NarinLab/Udawa/README.md

# Udawa 
Universal Digital Agriculture Watering Assistant or known by the brand name UDAWA, is an open-source precision farming platform designed and developed to be used by small-scale farmers especially in hydroponic based growing system. UDAWA was developed by the Information Technology Study Program, Faculty of Engineering and Informatics, Universitas Pendidikan Nasional. The UDAWA platform consists of a build and use manual, hardware design, software source code and serverless computing architecture design. So, the UDAWA platform can be used and developed by anyone freely. In terms of functionality, the UDAWA platform provides benefits in terms of automation and computerization of farming processes, thereby increasing the productivity and efficiency of smallholder farming processes who has a lack in funding or access to the latest technology in agriculture.
