NarinLab/Udawa/(threads)

Thread 3 (2021-09-09):

UDAWA Actuator4CH - Tambah Screw Terminal Block

iwas108, 2021-09-09:
Pada issue ini main tasknya adalah menambahkan koneksi ke modul relay 4 Channel.
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

Relay 4 Channel punya 4 pin input (INx atau pada gambar diagram Cx). 4 Pin input ini dipetakan ke pin ESP32 yang telah dicek terlebih dahulu untuk memastikan pin tersebut tidak menimbulkan masalah jika digunakan (search: ESP32 usable pin). Masing-masing dimulai dari **C1 hingga C4: D32, D33, D25, D26**. Pin GND dan pin 5V disambungkan ke pin yang sama.

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

Untuk bagian tegangan tinggi (listrik PLN) yang akan mentenagai beban, sebelum masuk ke terminal block **~RCx** yang akan mengarah ke modul relay, ditambahkan fuse holder (rumah skring) kaca silinder sebagai pengaman. Kemudian, kabel ini akan masuk ke bagian **Common** dari masing-masing relay. Kabel yang satunya lagi keluar dari terminal NO (**Normally Open**) menuju ke PCB dan masuk di terminal **~NOx**. Dari terminal **~NOx**, daya listrik tegangan tinggi akan disambungkan oleh jalur tegangan tinggi PCB ke terminal akhir tempat dimana stop kontak akan disambungkan (**CHx**).

### To Do
1. Tambahkan pada skematik untuk terminal 220V (2 block x 1)
2. Tambahkan pada skematik untuk terminal AC/DC (2 block x 1)
3. Tambahkan pada skematik untuk terminal control relay (Cx + VCC + GND) (2 block x 3)
4. Tambahkan pada skematik untuk fuse holder (4 unit)
5. Tambahkan pada skematik untuk terminal block ~RCx (2 block x 2)
6. Tambahkan pada skematik untuk terminal block ~NOx (2 block x 2)
7. Tambahkan pada skematik untuk terminal block stop kontak CHx (2 block x 4)
8. Lakukan wiring pada mode board dan pastikan penamaan setiap pin dan konektor dibuat dengan jelas dan rapi sesuai diagram.

### Pembagian tugas
Pembagian tugas saya serahkan ke masing-masing tim leader, untuk penamaan branch pekerjaan saya bebaskan asal mengikuti aturan common sense sehingga jelas dan mudah untuk dimengerti. Untuk detail diskusi seperti nama part silahkan diskusi di issue ini agar terdokumentasi dengan baik untuk di masa depan, dan orang umum juga bisa melihat.

Tim leader juga bisa membuat issue tambahan sendiri untuk meassign rekannya tugas terkait. Ingat untuk menambahkan project di sidebar kanan halaman, gunakan projek sesuai issue yang sedang dikerjakan. Misalnya issue ini terkait dengan hardware pada varian Actuator4CH, maka project yang dikaitkan adalah HW-Actuator-4CH. Untuk label bisa gunakan **enhancement** untuk pengerjaan fitur baru.

iwas108, 2021-09-09:
Untuk fuse holder, tolong dibantu untuk mencarikan part number yang cocok di eagle. Kita gunakan model Fuse Holder PCB Mount 5x20 seperti ini:
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

artawiguna, 2021-09-09:
selamat malam pak, ijin bertanya untuk relaynya 2 block x3 itu jadinya 6 ya pak... kalau sesuai di diagram ada 4 pak, jadinya pakai yang mana pak?

iwas108, 2021-09-09:
> selamat malam pak, ijin bertanya untuk relaynya 2 block x3 itu jadinya 6 ya pak... kalau sesuai di diagram ada 4 pak, jadinya pakai yang mana pak?

Maksudnya jika ada 6 pin yang akan dipasangkan terminal block, maka kita gunakan terminal block 2 pin sebanyak 3 buah. Atau biar tidak ruwet, semua pin kita gunakan terminal block 2 pin (**W237-102**).

Untuk fuse holder sudah ketemu: http://www.diymodules.org/eagle-show-object?type=std&file=fuse.lbr&package=FUSE_HOLDER_5X20MM

Tolong dibantu untuk download dan tambah library tersebut ke folder library.

artawiguna, 2021-09-09:
kemudian  terminal 220V di tambahkan dimananya pak?
soalnya kalo ga salah di eagle sudah di tambahkan pak

iwas108, 2021-09-09:
> kemudian terminal 220V di tambahkan dimananya pak?
> soalnya kalo ga salah di eagle sudah di tambahkan pak

Terminal yg sudah ada tidak perlu ditambahkan lagi, itu hanya untuk melengkapi diagram saja

artawiguna, 2021-09-09:
> semua

oww jadi pin nya ada 6 yaa pak... maaf saya kira tadi relaynya 6 ch

iwas108, 2021-09-09:
> > semua
>
> oww jadi pin nya ada 6 yaa pak... maaf saya kira tadi relaynya 6 ch

Yes, Pin relay 4 channel punya 6 pin,4 untuk kontrol (C1, C2, C3, C4), dan dua untuk power (5V dan GND).

artawiguna, 2021-09-09:
malam pak ijin bertanya kembali untuk penamaan setiap pin tidak bisa sesuai dengan diagram karena pin yang kedua menyesuaikan valuenya dengan pin yang pertama, mohon arahannya
terimakasih
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

iwas108, 2021-09-10:
> malam pak ijin bertanya kembali untuk penamaan setiap pin tidak bisa sesuai dengan diagram karena pin yang kedua menyesuaikan valuenya dengan pin yang pertama, mohon arahannya
> terimakasih
> 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

Coba di samain saja namamya, NO12, NO34.. untuk nama wire/label pastikan sama agar terhubung

artawiguna, 2021-09-10:
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

baik siap pak

artawiguna, 2021-09-13:
Selamat pagi pak ijin bertanya untuk GND dan 5V yang dari HLK boleh di pindah pak?
soalnya Relaynya jauh jadinya ngambil GND dan 5V... maksunya itu di switch

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

iwas108, 2021-09-13:
Slamat pagi, dipindah saja yg penting efisien dan pikirkan nanti kemudahannya untuk mengakses komponen

artawiguna, 2021-09-14:
> Slamat pagi, dipindah saja yg penting efisien dan pikirkan nanti kemudahannya untuk mengakses komponen
baik siap pak

Closed 2021-11-12.

Thread 5 (2021-09-09):

UDAWA Sensor Water - Tambahkan Library Berikut ke Folder Hardware/Lib

iwas108, 2021-09-09:
Perlu bantuan untuk mencari dan menambahkan library pendukung untuk projek Sensor Water (Water sensor dengan TDS dan Temperature):

1.  Arduino Nano
2. Bi-Directional Logic Level Converter

iwas108, 2021-09-09:
Tim leader bisa assign rekannya yang lain untuk membantu, ada dua orang yang belum approve invitation untuk jadi kolaborator

Closed 2021-09-13.

Thread 6 (2021-09-09):

UDAWA Sensor Water - Tambah Komponen Utama

iwas108, 2021-09-09:
Pekerjaan besar untuk tim yang mengerjakan HW Sensor varian water sensor (TDS dan Water Temperature). Untuk diagram pengkabelan dibuat seperti berikut:

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

### To do
1. Tambahkan komponen Arduino Nano
2. Tambahkan komponen Logic Level Converter
3. Tambahkan Terminal Block untuk koneksi ke Sensor TDS dan Sensor DS18B20
3. Lakukan Wiring sesuai diagram
4. Lakukan Routing pada mode board

### Pengerjaan
Tim leader bisa bagi tugas kepada rekannya yang lain, nama branch saya bebaskan asal sesuai common sense dan mudah dimengerti. Semua diskusi terkait issue silahkan diskusikan disini sebagai dokumentasi.

WidiaPrasetia, 2021-09-11:
Selamat malam pak,
Saya stuck di To Do no 3
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
Mohon petunjuknya untuk gambar yang saya kirimkan ini pak. Terima kasih

iwas108, 2021-09-13:
Pakai part resistor pras,rubah nilainya (value) sesuai gambar. Pakai jenis resistor through hole

WidiaPrasetia, 2021-09-13:
untuk penambahan terminal block untuk koneksi ke sensor ditambahkan di sebelah mana ya pak? karena digambar saya lihat semua langsung nyambung. maaf kalau ada keliru pak

iwas108, 2021-09-13:
> untuk penambahan terminal block untuk koneksi ke sensor ditambahkan di sebelah mana ya pak? karena digambar saya lihat semua langsung nyambung. maaf kalau ada keliru pak

Di bagian sensornya. Anggap sensor itu terminal block.

pande34, 2021-09-17:
ijin bertanya Pak Adit untuk kabelnya ngga boleh ditumpuk pak?

pande34, 2021-09-17:
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

iwas108, 2021-09-18:
routing nya tidak boleh di tumpuk, itu tantangannya saat merouting dan mengatur tata letak, bagaimana caranya agar jalur data / power tidak saling bertabrakan atau bersentuhan.

Solusi akhir juga terlalu rumit, bisa gunakan vias pada sisi bottom. Bisa cari di youtube cara menggunakan vias di eagle untuk menambahkan jalur biru (bawah).

Closed 2021-11-12.

Thread 7 (2021-09-09):

Firmware - Init PlatformIO Untuk Actuator4CH-ESP32

NarinLab, 2021-09-09:
Buat folder Firmware di folder root repository, dan inisialisasi projek dengan PlatformIO (Pio). Detail projek yang diinisialisasi adalah:

1. Nama Projek: Actuator4CH-ESP32
2. Jenis Framework: Arduino
3. Jenis Board: esp32doit-devkit-v1
4. Tambahkan library: NTPClient, ArduinoJson, StreamUtils, LittleFS_esp32, TaskManagerIO

Sehingga folder Pio untuk Actuator4CH-ESP32 menjadi: **Firmware/Actuator4CH-ESP32**

Closed 2021-09-09.

Thread 8 (2021-09-09):

Firmware - Init PlatformIO Untuk SensorWater-ESP32

iwas108, 2021-09-09:
Inisialisasi projek untuk firmware SensorWater-ESP32 dengan PlatformIO (Pio). Detail projek yang diinisialisasi adalah:

1. Nama Projek: SensorWater-ESP32
2. Jenis Framework: Arduino
3. Jenis Board: esp32doit-devkit-v1
4. Tambahkan library: NTPClient, ArduinoJson, StreamUtils, LittleFS_esp32, TaskManagerIO

Sehingga folder Pio untuk Actuator4CH-ESP32 menjadi: Firmware/SensorWater-ESP32

Closed 2021-09-13.

Thread 9 (2021-09-09):

Firmware - Init PlatformIO Untuk SensorWater-Nano

iwas108, 2021-09-09:
Lakukan inisialisasi firmware untuk projek SensorWater-Nano dengan PlatformIO (Pio). Detail projek yang diinisialisasi adalah:

1. Nama Projek: SensorWater-Nano
2. Jenis Framework: Arduino
3. Jenis Board: nanoatmega328new
4. Tambahkan library: ArduinoJson, StreamUtils, TaskManagerIO, OneWire, DallasTemperature

Sehingga folder Pio untuk Actuator4CH-ESP32 menjadi: Firmware/SensorWater-Nano

WidiaPrasetia, 2021-09-10:
Selamat siang pak, saya mau bertanya pak.
Untuk kalimat ini "Sehingga folder Pio untuk Actuator4CH-ESP32 menjadi: Firmware/SensorWater-Nano" bagaimana maksudnya ya pak? Apakah ganti nama foldernya atau bagaimana pak?
Mohon arahannya pak, maaf saya sedikit bingung

iwas108, 2021-09-10:
> Selamat siang pak, saya mau bertanya pak. @iwas108
> Untuk kalimat ini "Sehingga folder Pio untuk Actuator4CH-ESP32 menjadi: Firmware/SensorWater-Nano" bagaimana maksudnya ya pak? Apakah ganti nama foldernya/buat project baru di PIO atau bagaimana pak?
> Mohon arahannya pak, maaf saya sedikit bingung

Pas buat projek, buat nama projeknya sesuai nama folder, dan lokasi projek taruh di dalam folder Firmware. Contohnya sama seperti yg saya init untuk firmware bagian Actuator4CH

Closed 2021-09-13.

Thread 17 (2021-10-15):

Test Code untuk Sensor TDS

iwas108, 2021-10-15:
Berikut penggalan test code untuk sensor TDS di board nano:

```
void MadavaCoMCU::getWaterEC(StaticJsonDocument<DOCSIZE> &doc)
{
  pinMode(configCoMCU.pinEcPower, OUTPUT);
  pinMode(configCoMCU.pinEcGnd, OUTPUT);
  pinMode(configCoMCU.pinEcData, INPUT);

  float ec = 0;
  float ec25 = 0;
  int ppm = 0;
  float raw = 0;
  float voltageDrop = 0;
  float rc = 0;
  float waterTemp = doc["params"]["waterTemp"].as<float>();

  digitalWrite(configCoMCU.pinEcPower, HIGH);
  raw = analogRead(configCoMCU.pinEcData);
  raw = analogRead(configCoMCU.pinEcData);
  digitalWrite(configCoMCU.pinEcPower, LOW);

  voltageDrop = (configCoMCU.pEcVin * raw) / 1024.0;
  rc =(voltageDrop * configCoMCU.pEcR1) / (configCoMCU.pEcVin - voltageDrop);
  rc = rc - configCoMCU.pEcRa;
  ec = 1000 / (rc * configCoMCU.pEcKcoe);

  ec25  =  ec / (1 + configCoMCU.pEcTcoe * (waterTemp - 25.0));
  ppm =(ec25) * (configCoMCU.pEcPpm * 1000);

  JsonObject params = doc.createNestedObject("params");
  doc["method"] = "setWaterEC";
  params["waterEC"] = ec25;
  params["waterPPM"] = ppm;
  params["waterTemp"] = waterTemp;
  params["vDrop"] = voltageDrop;
  params["_ec"] = ec;
  params["raw"] = raw;
  serialWriteToESP32(doc);
}

```

iwas108, 2021-11-06:
Contoh Syncron:

```
{
  "fPanic": false,
  "pEcKcoe": 2.9,
  "pEcTcoe": 0.019,
  "pEcVin": 4.54,
  "pEcPpm": 0.5,
  "pEcR1": 0.5,
  "pEcRa": 25,
  "bfreq": 1600,
  "fBuzz": true,
  "pRlyOn": false,
  "pRlyOff": true,
  "pinBuzzer": 3,
  "pinLedR": 9,
  "pinLedG": 10,
  "pinLedB": 11,
  "pinEcPower": 15,
  "pinEcGnd": 16,
  "pinEcData": 14,
  "method": "setConfigCoMCU"
}
```

artawiguna, 2021-11-06:
/*
  ElCheapo Arduino EC-PPM measurments

  This scrip uses a common USA two prong plug and a 47Kohm Resistor to measure the EC/PPM of a Aquaponics/Hydroponics Sytem.
  You could modift this code to Measure other liquids if you change the resitor and values at the top of the code.

  This Program will give you a temperature based feed controller. See Read me in download file for more info.

  28/8/2015  Michael Ratcliffe  Mike@MichaelRatcliffe.com

          This program is free software: you can redistribute it and/or modify
    it under the terms of the GNU General Public License as published by
    the Free Software Foundation, either version 3 of the License, or
    (at your option) any later version.

    This program is distributed in the hope that it will be useful,
    but WITHOUT ANY WARRANTY; without even the implied warranty of
    MERCHANTABILITY or FITNESS FOR A PARTICULAR PURPOSE.  See the
    GNU General Public License for more details.

    You should have received a copy of the GNU General Public License
    along with this program.  If not, see .

    Parts:
    -Arduino - Uno/Mega
    -Standard American two prong plug
    -1 kohm resistor
    -DS18B20 Waterproof Temperature Sensor

    Limitations:
    -
    -

    See www.MichaelRatcliffe.com/Projects for a Pinout and user guide or consult the Zip you got this code from

*/

//************************** Libraries Needed To Compile The Script [See Read me In Download] ***************//
// Both below Library are custom ones [ SEE READ ME In Downloaded Zip If You Dont Know how To install] Use them or add a pull up resistor to the temp probe

#include <OneWire.h>
#include <DallasTemperature.h>

//************************* User Defined Variables ********************************************************//

//##################################################################################
//-----------  Do not Replace R1 with a resistor lower than 300 ohms    ------------
//##################################################################################

int R1= 1000;
int Ra=25; //Resistance of powering Pins
int ECPin= 14;
int ECGround= 16;
int ECPower = 15;

//*********** Converting to ppm [Learn to use EC it is much better**************//
// Hana      [USA]        PPMconverion:  0.5
// Eutech    [EU]          PPMconversion:  0.64
//Tranchen  [Australia]  PPMconversion:  0.7
// Why didnt anyone standardise this?

float PPMconversion=0.7;

//*************Compensating for temperature ************************************//
//The value below will change depending on what chemical solution we are measuring
//0.019 is generaly considered the standard for plant nutrients [google "Temperature compensation EC" for more info
float TemperatureCoef = 0.019; //this changes depending on what chemical we are measuring

//********************** Cell Constant For Ec Measurements *********************//
//Mine was around 2.9 with plugs being a standard size they should all be around the same
//But If you get bad readings you can use the calibration script and fluid to get a better estimate for K
float K=2.9;

//************ Temp Probe Related *********************************************//
#define ONE_WIRE_BUS 2          // Data wire For Temp Probe is plugged into pin 10 on the Arduino
const int TempProbePossitive =8;  //Temp Probe power connected to pin 9
const int TempProbeNegative=9;    //Temp Probe Negative connected to pin 8

//***************************** END Of Recomended User Inputs *****************************************************************//

OneWire oneWire(ONE_WIRE_BUS);// Setup a oneWire instance to communicate with any OneWire devices
DallasTemperature sensors(&oneWire);// Pass our oneWire reference to Dallas Temperature.

float Temperature=10;
float EC=0;
float EC25 =0;
int ppm =0;

float raw= 0;
float Vin= 5;
float Vdrop= 0;
float Rc= 0;
float buffer=0;

//*********************************Setup - runs Once and sets pins etc ******************************************************//
void setup()
{
  Serial.begin(9600);
  pinMode(TempProbeNegative , OUTPUT ); //seting ground pin as output for tmp probe
  digitalWrite(TempProbeNegative , LOW );//Seting it to ground so it can sink current
  pinMode(TempProbePossitive , OUTPUT );//ditto but for positive
  digitalWrite(TempProbePossitive , HIGH );
  pinMode(ECPin,INPUT);
  pinMode(ECPower,OUTPUT);//Setting pin for sourcing current
  pinMode(ECGround,OUTPUT);//setting pin for sinking current
  digitalWrite(ECGround,LOW);//We can leave the ground connected permanantly

  delay(100);// gives sensor time to settle
  sensors.begin();
  delay(100);
  //** Adding Digital Pin Resistance to [25 ohm] to the static Resistor *********//
  // Consule Read-Me for Why, or just accept it as true
  R1=(R1+Ra);// Taking into acount Powering Pin Resitance

  Serial.println("ElCheapo Arduino EC-PPM measurments");
  Serial.println("By: Michael Ratcliffe  Mike@MichaelRatcliffe.com");
  Serial.println("Free software: you can redistribute it and/or modify it under GNU ");
  Serial.println("");
  Serial.println("Make sure Probe and Temp Sensor are in Solution and solution is well mixed");
  Serial.println("");
  Serial.println("Measurments at 5's Second intervals [Dont read Ec morre than once every 5 seconds]:");

};
//******************************************* End of Setup **********************************************************************//

//************************************* Main Loop - Runs Forever ***************************************************************//
//Moved Heavy Work To subroutines so you can call them from main loop without cluttering the main loop
void loop()
{

GetEC();          //Calls Code to Go into GetEC() Loop [Below Main Loop] dont call this more that 1/5 hhz [once every five seconds] or you will polarise the water
PrintReadings();  // Cals Print routine [below main loop]

delay(5000);

}
//************************************** End Of Main Loop **********************************************************************//

//************ This Loop Is called From Main Loop************************//
void GetEC(){

//*********Reading Temperature Of Solution *******************//
sensors.requestTemperatures();// Send the command to get temperatures
Temperature=sensors.getTempCByIndex(0); //Stores Value in Variable

//************Estimates Resistance of Liquid ****************//
digitalWrite(ECPower,HIGH);
raw= analogRead(ECPin);
raw= analogRead(ECPin);// This is not a mistake, First reading will be low beause if charged a capacitor
digitalWrite(ECPower,LOW);

//***************** Converts to EC **************************//
Vdrop= (Vin*raw)/1024.0;
Rc=(Vdrop*R1)/(Vin-Vdrop);
Rc=Rc-Ra; //acounting for Digital Pin Resitance
EC = 1000/(Rc*K);

//*************Compensating For Temperaure********************//
EC25  =  EC/ (1+ TemperatureCoef*(Temperature-25.0));
ppm=(EC25)*(PPMconversion*1000);

;}
//************************** End OF EC Function ***************************//

//***This Loop Is called From Main Loop- Prints to serial usefull info ***//
void PrintReadings(){
Serial.print("Rc: ");
Serial.print(Rc);
Serial.print(" EC: ");
Serial.print(EC25);
Serial.print(" Simens  ");
Serial.print(ppm);
Serial.print(" ppm  ");
Serial.print(Temperature);
Serial.println(" *C ");

/*
//********** Usued for Debugging ************
Serial.print("Vdrop: ");
Serial.println(Vdrop);
Serial.print("Rc: ");
Serial.println(Rc);
Serial.print(EC);
Serial.println("Siemens");
//********** end of Debugging Prints *********
*/
};

iwas108, 2021-11-06:
```
*/

//************************** Libraries Needed To Compile The Script [See Read me In Download] ***************//
// Both below Library are custom ones [ SEE READ ME In Downloaded Zip If You Dont Know how To install] Use them or add a pull up resistor to the temp probe

#include <OneWire.h>
#include <DallasTemperature.h>

//************************* User Defined Variables ********************************************************//

//##################################################################################
//----------- Do not Replace R1 with a resistor lower than 300 ohms ------------
//##################################################################################

int R1= 1000;
int Ra=25; //Resistance of powering Pins
int ECPin= 14;
int ECGround= 16;
int ECPower = 15;

//*********** Converting to ppm [Learn to use EC it is much better**************//
// Hana [USA] PPMconverion: 0.5
// Eutech [EU] PPMconversion: 0.64
//Tranchen [Australia] PPMconversion: 0.7
// Why didnt anyone standardise this?

float PPMconversion=0.7;

//*************Compensating for temperature ************************************//
//The value below will change depending on what chemical solution we are measuring
//0.019 is generaly considered the standard for plant nutrients [google "Temperature compensation EC" for more info
float TemperatureCoef = 0.019; //this changes depending on what chemical we are measuring

//********************** Cell Constant For Ec Measurements *********************//
//Mine was around 2.9 with plugs being a standard size they should all be around the same
//But If you get bad readings you can use the calibration script and fluid to get a better estimate for K
float K=2.9;

//************ Temp Probe Related *********************************************//
#define ONE_WIRE_BUS 2 // Data wire For Temp Probe is plugged into pin 10 on the Arduino
const int TempProbePossitive =8; //Temp Probe power connected to pin 9
const int TempProbeNegative=9; //Temp Probe Negative connected to pin 8

//***************************** END Of Recomended User Inputs *****************************************************************//

OneWire oneWire(ONE_WIRE_BUS);// Setup a oneWire instance to communicate with any OneWire devices
DallasTemperature sensors(&oneWire);// Pass our oneWire reference to Dallas Temperature.

float Temperature=10;
float EC=0;
float EC25 =0;
int ppm =0;

float raw= 0;
float Vin= 5;
float Vdrop= 0;
float Rc= 0;
float buffer=0;

//*********************************Setup - runs Once and sets pins etc ******************************************************//
void setup()
{
Serial.begin(9600);
pinMode(TempProbeNegative , OUTPUT ); //seting ground pin as output for tmp probe
digitalWrite(TempProbeNegative , LOW );//Seting it to ground so it can sink current
pinMode(TempProbePossitive , OUTPUT );//ditto but for positive
digitalWrite(TempProbePossitive , HIGH );
pinMode(ECPin,INPUT);
pinMode(ECPower,OUTPUT);//Setting pin for sourcing current
pinMode(ECGround,OUTPUT);//setting pin for sinking current
digitalWrite(ECGround,LOW);//We can leave the ground connected permanantly

delay(100);// gives sensor time to settle
sensors.begin();
delay(100);
//** Adding Digital Pin Resistance to [25 ohm] to the static Resistor *********//
// Consule Read-Me for Why, or just accept it as true
R1=(R1+Ra);// Taking into acount Powering Pin Resitance

Serial.println("ElCheapo Arduino EC-PPM measurments");
Serial.println("By: Michael Ratcliffe Mike@MichaelRatcliffe.com");
Serial.println("Free software: you can redistribute it and/or modify it under GNU ");
Serial.println("");
Serial.println("Make sure Probe and Temp Sensor are in Solution and solution is well mixed");
Serial.println("");
Serial.println("Measurments at 5's Second intervals [Dont read Ec morre than once every 5 seconds]:");

};
//******************************************* End of Setup **********************************************************************//

//************************************* Main Loop - Runs Forever ***************************************************************//
//Moved Heavy Work To subroutines so you can call them from main loop without cluttering the main loop
void loop()
{

GetEC(); //Calls Code to Go into GetEC() Loop [Below Main Loop] dont call this more that 1/5 hhz [once every five seconds] or you will polarise the water
PrintReadings(); // Cals Print routine [below main loop]

delay(5000);

}
//************************************** End Of Main Loop **********************************************************************//

//************ This Loop Is called From Main Loop************************//
void GetEC(){

//*********Reading Temperature Of Solution *******************//
sensors.requestTemperatures();// Send the command to get temperatures
Temperature=sensors.getTempCByIndex(0); //Stores Value in Variable

//************Estimates Resistance of Liquid ****************//
digitalWrite(ECPower,HIGH);
raw= analogRead(ECPin);
raw= analogRead(ECPin);// This is not a mistake, First reading will be low beause if charged a capacitor
digitalWrite(ECPower,LOW);

//***************** Converts to EC **************************//
Vdrop= (Vinraw)/1024.0;
Rc=(VdropR1)/(Vin-Vdrop);
Rc=Rc-Ra; //acounting for Digital Pin Resitance
EC = 1000/(Rc*K);

//Compensating For Temperaure*******//
EC25 = EC/ (1+ TemperatureCoef*(Temperature-25.0));
ppm=(EC25)(PPMconversion1000);

;}
//************************** End OF EC Function ***************************//

//***This Loop Is called From Main Loop- Prints to serial usefull info ***//
void PrintReadings(){
Serial.print("Rc: ");
Serial.print(Rc);
Serial.print(" EC: ");
Serial.print(EC25);
Serial.print(" Simens ");
Serial.print(ppm);
Serial.print(" ppm ");
Serial.print(Temperature);
Serial.println(" *C ");

/*
//********** Usued for Debugging ************
Serial.print("Vdrop: ");
Serial.println(Vdrop);
Serial.print("Rc: ");
Serial.println(Rc);
Serial.print(EC);
Serial.println("Siemens");
//********** end of Debugging Prints *********
*/
};
```

artawiguna, 2021-11-06:
```
/*
  ElCheapo Arduino EC-PPM measurments

  This scrip uses a common USA two prong plug and a 47Kohm Resistor to measure the EC/PPM of a Aquaponics/Hydroponics Sytem.
  You could modift this code to Measure other liquids if you change the resitor and values at the top of the code.

  This Program will give you a temperature based feed controller. See Read me in download file for more info.

  28/8/2015  Michael Ratcliffe  Mike@MichaelRatcliffe.com

          This program is free software: you can redistribute it and/or modify
    it under the terms of the GNU General Public License as published by
    the Free Software Foundation, either version 3 of the License, or
    (at your option) any later version.

    This program is distributed in the hope that it will be useful,
    but WITHOUT ANY WARRANTY; without even the implied warranty of
    MERCHANTABILITY or FITNESS FOR A PARTICULAR PURPOSE.  See the
    GNU General Public License for more details.

    You should have received a copy of the GNU General Public License
    along with this program.  If not, see .

    Parts:
    -Arduino - Uno/Mega
    -Standard American two prong plug
    -1 kohm resistor
    -DS18B20 Waterproof Temperature Sensor

    Limitations:
    -
    -

    See www.MichaelRatcliffe.com/Projects for a Pinout and user guide or consult the Zip you got this code from

*/

//************************** Libraries Needed To Compile The Script [See Read me In Download] ***************//
// Both below Library are custom ones [ SEE READ ME In Downloaded Zip If You Dont Know how To install] Use them or add a pull up resistor to the temp probe

#include <OneWire.h>
#include <DallasTemperature.h>

//************************* User Defined Variables ********************************************************//

//##################################################################################
//-----------  Do not Replace R1 with a resistor lower than 300 ohms    ------------
//##################################################################################

int R1= 1000;
int Ra=25; //Resistance of powering Pins
int ECPin= 14;
int ECGround= 16;
int ECPower = 15;

//*********** Converting to ppm [Learn to use EC it is much better**************//
// Hana      [USA]        PPMconverion:  0.5
// Eutech    [EU]          PPMconversion:  0.64
//Tranchen  [Australia]  PPMconversion:  0.7
// Why didnt anyone standardise this?

float PPMconversion=0.7;

//*************Compensating for temperature ************************************//
//The value below will change depending on what chemical solution we are measuring
//0.019 is generaly considered the standard for plant nutrients [google "Temperature compensation EC" for more info
float TemperatureCoef = 0.019; //this changes depending on what chemical we are measuring

//********************** Cell Constant For Ec Measurements *********************//
//Mine was around 2.9 with plugs being a standard size they should all be around the same
//But If you get bad readings you can use the calibration script and fluid to get a better estimate for K
float K=2.9;

//************ Temp Probe Related *********************************************//
#define ONE_WIRE_BUS 2          // Data wire For Temp Probe is plugged into pin 10 on the Arduino
const int TempProbePossitive =8;  //Temp Probe power connected to pin 9
const int TempProbeNegative=9;    //Temp Probe Negative connected to pin 8

//***************************** END Of Recomended User Inputs *****************************************************************//

OneWire oneWire(ONE_WIRE_BUS);// Setup a oneWire instance to communicate with any OneWire devices
DallasTemperature sensors(&oneWire);// Pass our oneWire reference to Dallas Temperature.

float Temperature=10;
float EC=0;
float EC25 =0;
int ppm =0;

float raw= 0;
float Vin= 5;
float Vdrop= 0;
float Rc= 0;
float buffer=0;

//*********************************Setup - runs Once and sets pins etc ******************************************************//
void setup()
{
  Serial.begin(9600);
  pinMode(TempProbeNegative , OUTPUT ); //seting ground pin as output for tmp probe
  digitalWrite(TempProbeNegative , LOW );//Seting it to ground so it can sink current
  pinMode(TempProbePossitive , OUTPUT );//ditto but for positive
  digitalWrite(TempProbePossitive , HIGH );
  pinMode(ECPin,INPUT);
  pinMode(ECPower,OUTPUT);//Setting pin for sourcing current
  pinMode(ECGround,OUTPUT);//setting pin for sinking current
  digitalWrite(ECGround,LOW);//We can leave the ground connected permanantly

  delay(100);// gives sensor time to settle
  sensors.begin();
  delay(100);
  //** Adding Digital Pin Resistance to [25 ohm] to the static Resistor *********//
  // Consule Read-Me for Why, or just accept it as true
  R1=(R1+Ra);// Taking into acount Powering Pin Resitance

  Serial.println("ElCheapo Arduino EC-PPM measurments");
  Serial.println("By: Michael Ratcliffe  Mike@MichaelRatcliffe.com");
  Serial.println("Free software: you can redistribute it and/or modify it under GNU ");
  Serial.println("");
  Serial.println("Make sure Probe and Temp Sensor are in Solution and solution is well mixed");
  Serial.println("");
  Serial.println("Measurments at 5's Second intervals [Dont read Ec morre than once every 5 seconds]:");

};
//******************************************* End of Setup **********************************************************************//

//************************************* Main Loop - Runs Forever ***************************************************************//
//Moved Heavy Work To subroutines so you can call them from main loop without cluttering the main loop
void loop()
{

GetEC();          //Calls Code to Go into GetEC() Loop [Below Main Loop] dont call this more that 1/5 hhz [once every five seconds] or you will polarise the water
PrintReadings();  // Cals Print routine [below main loop]

delay(5000);

}
//************************************** End Of Main Loop **********************************************************************//

//************ This Loop Is called From Main Loop************************//
void GetEC(){

//*********Reading Temperature Of Solution *******************//
sensors.requestTemperatures();// Send the command to get temperatures
Temperature=sensors.getTempCByIndex(0); //Stores Value in Variable

//************Estimates Resistance of Liquid ****************//
digitalWrite(ECPower,HIGH);
raw= analogRead(ECPin);
raw= analogRead(ECPin);// This is not a mistake, First reading will be low beause if charged a capacitor
digitalWrite(ECPower,LOW);

//***************** Converts to EC **************************//
Vdrop= (Vin*raw)/1024.0;
Rc=(Vdrop*R1)/(Vin-Vdrop);
Rc=Rc-Ra; //acounting for Digital Pin Resitance
EC = 1000/(Rc*K);

//*************Compensating For Temperaure********************//
EC25  =  EC/ (1+ TemperatureCoef*(Temperature-25.0));
ppm=(EC25)*(PPMconversion*1000);

;}
//************************** End OF EC Function ***************************//

//***This Loop Is called From Main Loop- Prints to serial usefull info ***//
void PrintReadings(){
Serial.print("Rc: ");
Serial.print(Rc);
Serial.print(" EC: ");
Serial.print(EC25);
Serial.print(" Simens  ");
Serial.print(ppm);
Serial.print(" ppm  ");
Serial.print(Temperature);
Serial.println(" *C ");

/*
//********** Usued for Debugging ************
Serial.print("Vdrop: ");
Serial.println(Vdrop);
Serial.print("Rc: ");
Serial.println(Rc);
Serial.print(EC);
Serial.println("Siemens");
//********** end of Debugging Prints *********
*/
};
```

Closed 2021-11-12.

Thread 18 (2021-10-30):

Secret.h No Such File or Directory

iwas108, 2021-10-30:
File secret isinya adalah sandi dan key untuk akses ke broker, termasuk juga jaringan WiFi. Jadi ada file secret.h-example di folder .pio\libdeps\esp32doit-devkit-v1\libudawa\src, ganti isinya dengan penyesuaian masing-masing, dengan cara mengcopy file tersebut dan rubah namanya menjadi secret.h saja. Untuk projek internal PRITA isian file telah dicopy di grup command center.

Closed 2021-11-12.

Thread 19 (2021-10-30):

Cara upload menggunakan kabel

iwas108, 2021-10-30:
Secara bawaan, isi file platformio.ini akan seperti berikut:

```
[env:esp32doit-devkit-v1]
platform = espressif32
board = esp32doit-devkit-v1
framework = arduino
monitor_speed = 115200
monitor_filters = esp32_exception_decoder
;upload_protocol = esptool
;upload_port = COM4
upload_protocol = espota
upload_port = udawa.local
upload_flags =
	--port=3232
	--auth=harinama
build_flags =
	${env.build_flags}
	-D=${PIOENV}
	-DCORE_DEBUG_LEVEL=4
lib_deps =
	arduino-libraries/NTPClient@^3.1.0
	bblanchon/ArduinoJson@^6.18.4
	bblanchon/StreamUtils@^1.6.1
	davetcc/TaskManagerIO@^1.2.3
	https://github.com/thingsboard/thingsboard-arduino-sdk
	https://github.com/NarinLab/libudawa
	knolleary/PubSubClient@^2.8

```

Konfigurasi tersebut adalah untuk perangkat UDAWA yang telah memiliki kode OTA Update via WiFi, untuk dapat mengupload kode menggunakan kabel (saat pertama kali memprogram alat), gunakan konfigurasi berikut:

```
[env:esp32doit-devkit-v1]
platform = espressif32
board = esp32doit-devkit-v1
framework = arduino
monitor_speed = 115200
monitor_filters = esp32_exception_decoder
upload_protocol = esptool
upload_port = COM4
;upload_protocol = espota
;upload_port = udawa.local
;upload_flags =
;	--port=3232
;	--auth=harinama
build_flags =
	${env.build_flags}
	-D=${PIOENV}
	-DCORE_DEBUG_LEVEL=4
lib_deps =
	arduino-libraries/NTPClient@^3.1.0
	bblanchon/ArduinoJson@^6.18.4
	bblanchon/StreamUtils@^1.6.1
	davetcc/TaskManagerIO@^1.2.3
	https://github.com/thingsboard/thingsboard-arduino-sdk
	https://github.com/NarinLab/libudawa
	knolleary/PubSubClient@^2.8

```

pastikan mengganti nomer port COM dengan nomer yang sesuai.

Closed 2021-11-12.
