NarinLab/Udawa/Hardware/UDAWA-Aktuator gabung.pdf

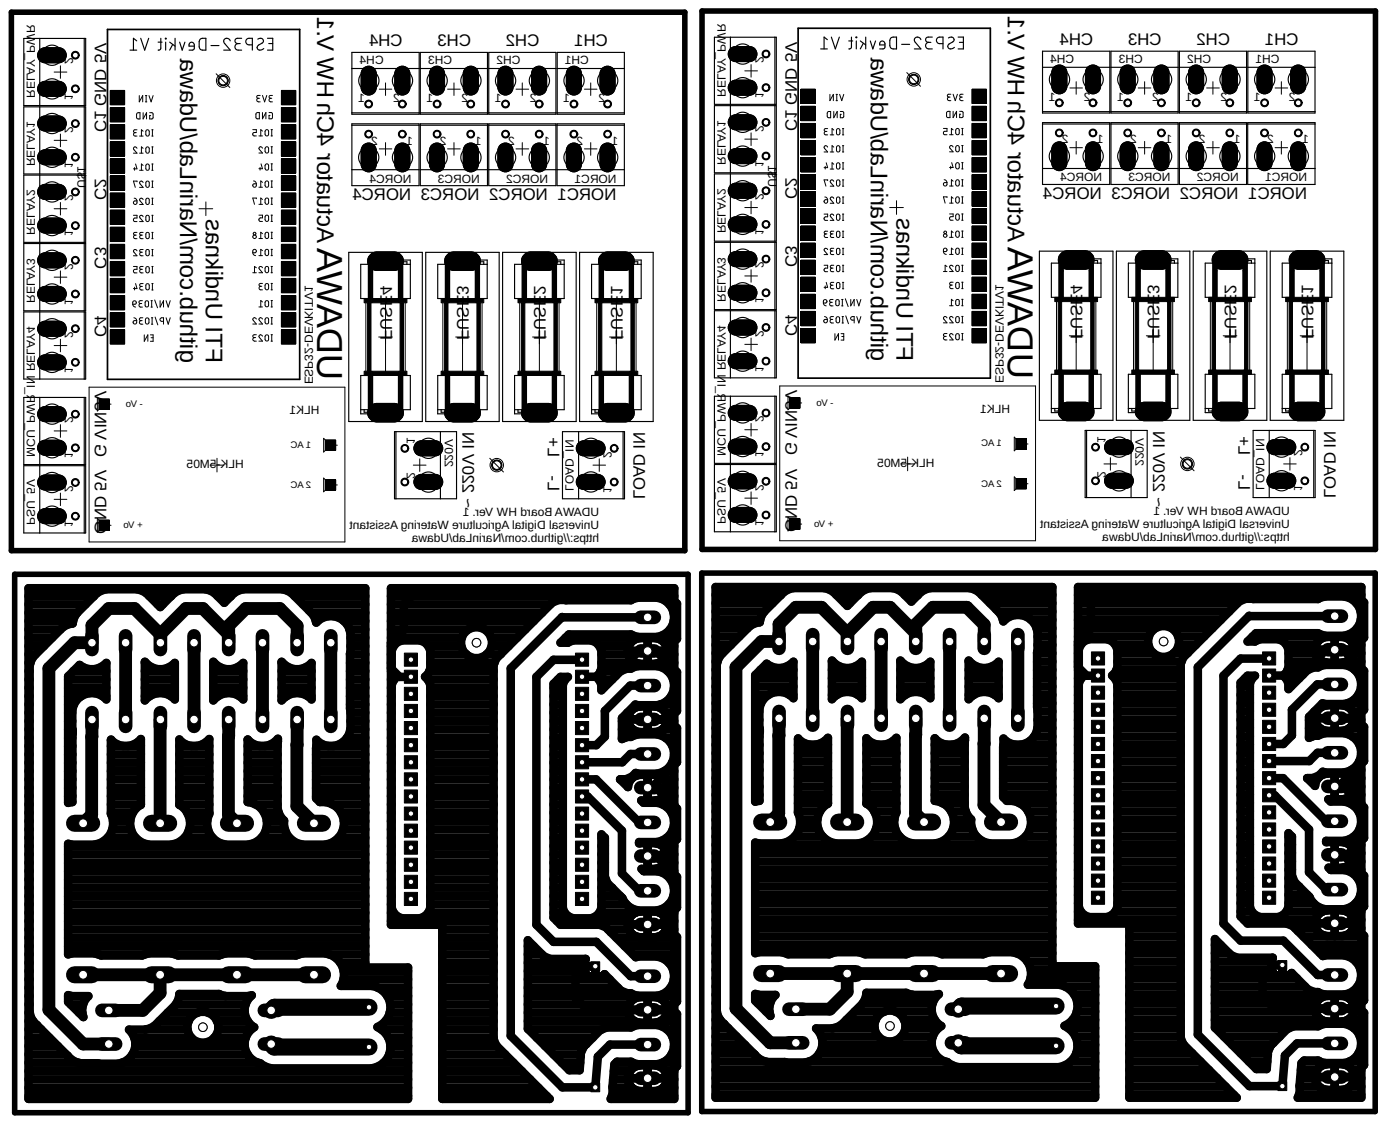
[picture p1: page 1]

HLK1 U$1 1 2 1 2 2 1 2 1 2 1 2 1 1 2 1 2 1 2 1 21 2 1 2 1 2 1 2 ESP32-DEVKITV1 220V RELAY1 RELAY2 FUSE1 FUSE2 FUSE3 FUSE4RELAY3 RELAY4 4 CRON 3 CRON 2 CRON 1 CRON 4 HC 3 HC 2 HC 1 HC LOAD_IN RELAY_PWR PSU_5V MCU_PWR_IN 1.r eV WHdr aoB A WADU t nat si ss Agnir et a Wer utl ucir gAl ati gi Dl asr evi n U a wad U/ baLnir a N/ moc. buhti g//: sptt h UDAWA HW V.1 github.com/NarinLab/Udawa FTI UndiknasActuator 4Ch GND G 5V VIN5V C4 C3 C2 C1 5V GND 4 HC 3 HC 2 HC 1 HC 4 CRON 3 CRON 2 CRON 1 CRON ~ 220V IN LOAD INL+ L- 1 2 1 2 1 2 50 M5- KL H CA1 CA2 oV- oV + 1KL H U$1 1 2 1 2 2 1 2 1 2 1 2 1 1 2 1 2 1 2 1 21 2 1 2 1 2 1 2

https://github.com/NarinLab/Udawa UDAWA HW V.1 github.com/NarinLab/Udawa FTI UndiknasActuator 4Ch GND G 5V VIN5V C4 C3 C2 C1 5V GND

UDAWA Board HW Ver. 1 Universal Digital Agriculture Watering Assistant
