NarinLab/Udawa/Hardware/UDAWA-SensorWater gabung.pdf

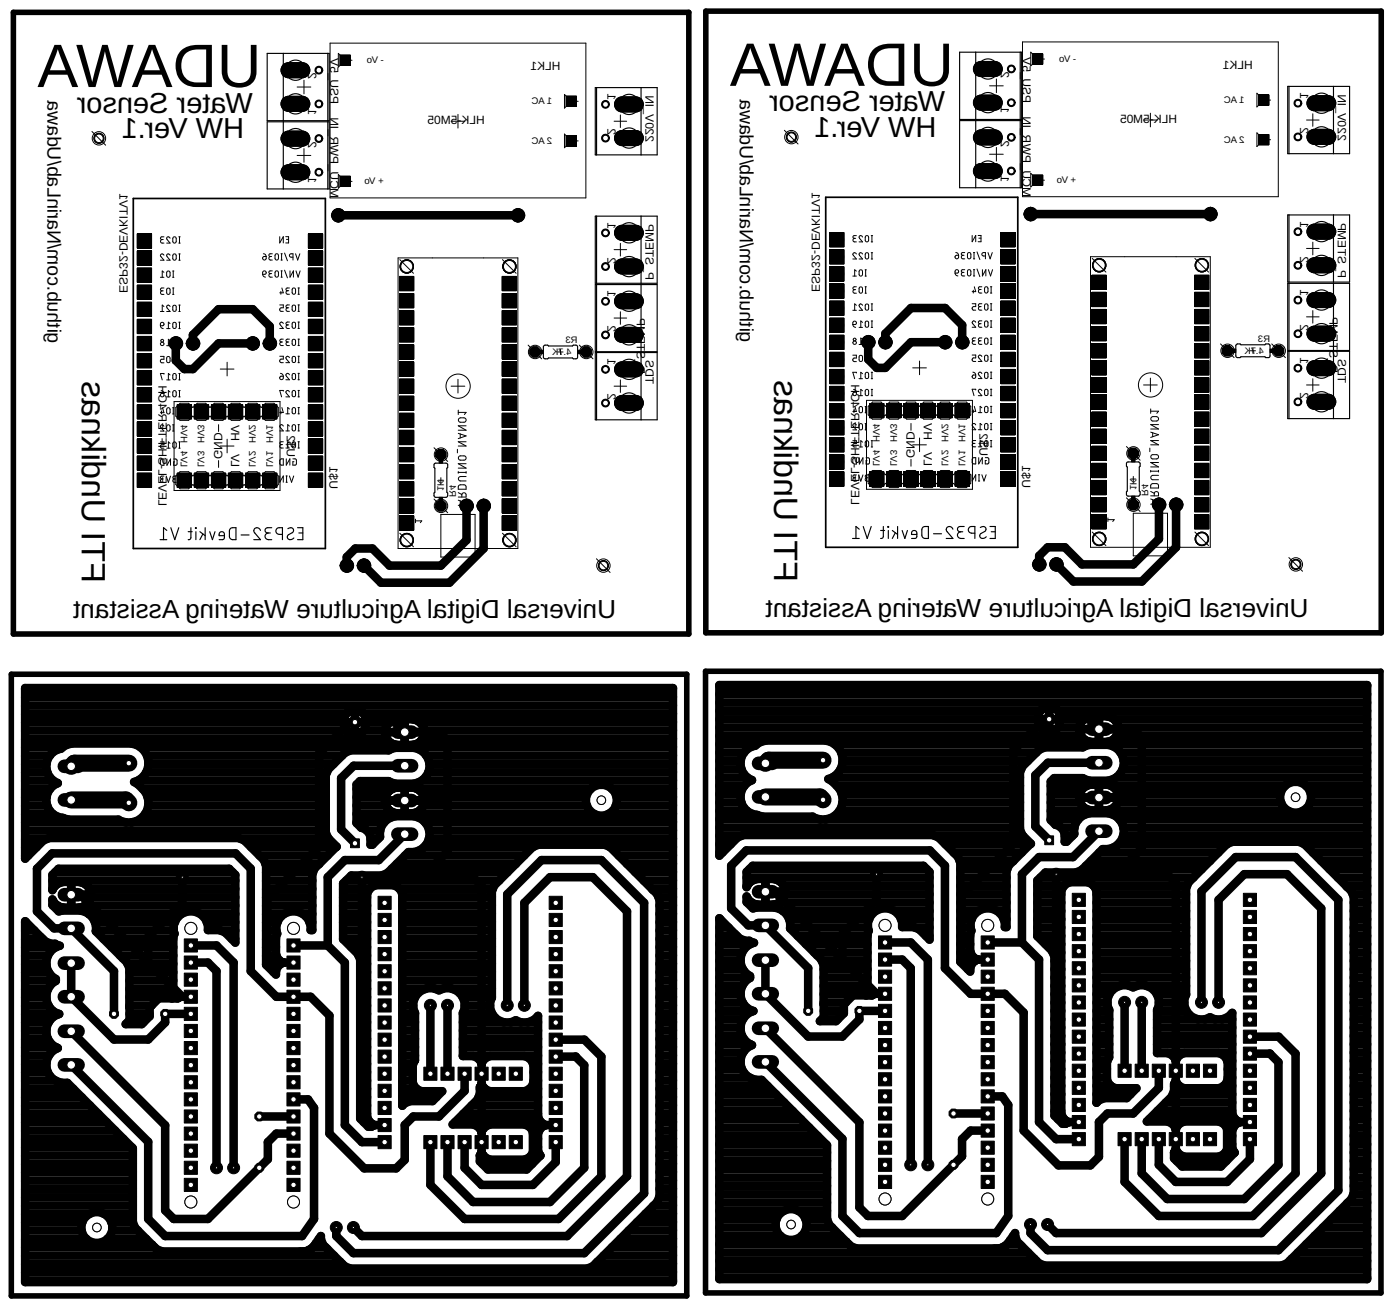
[picture p2: page 1]

github.com/NarinLab/Udawa 1.r eV WH
