NarinLab/Udawa/Hardware/UDAWA-Aktuator4CH/UDAWA-Aktuator4CH.pdf

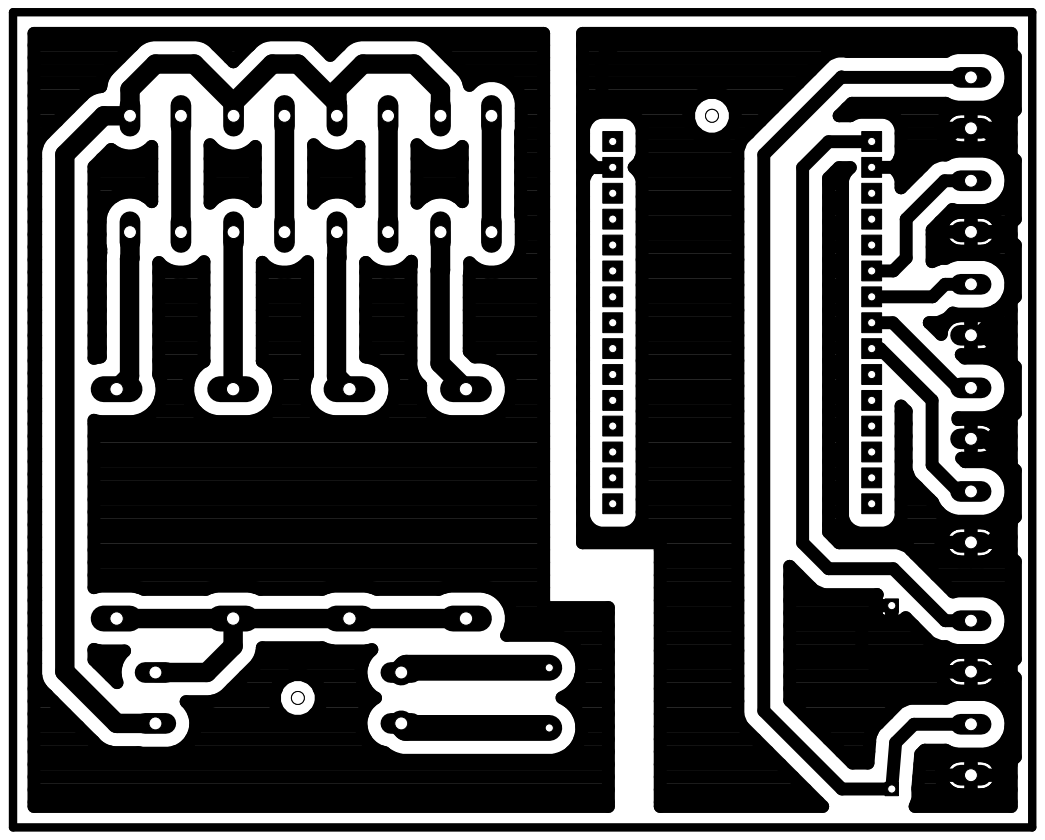
[picture p3: page 1]
