NarinLab/Udawa/Hardware/UDAWA-SensorWater/UDAWA-SensorWater.pdf

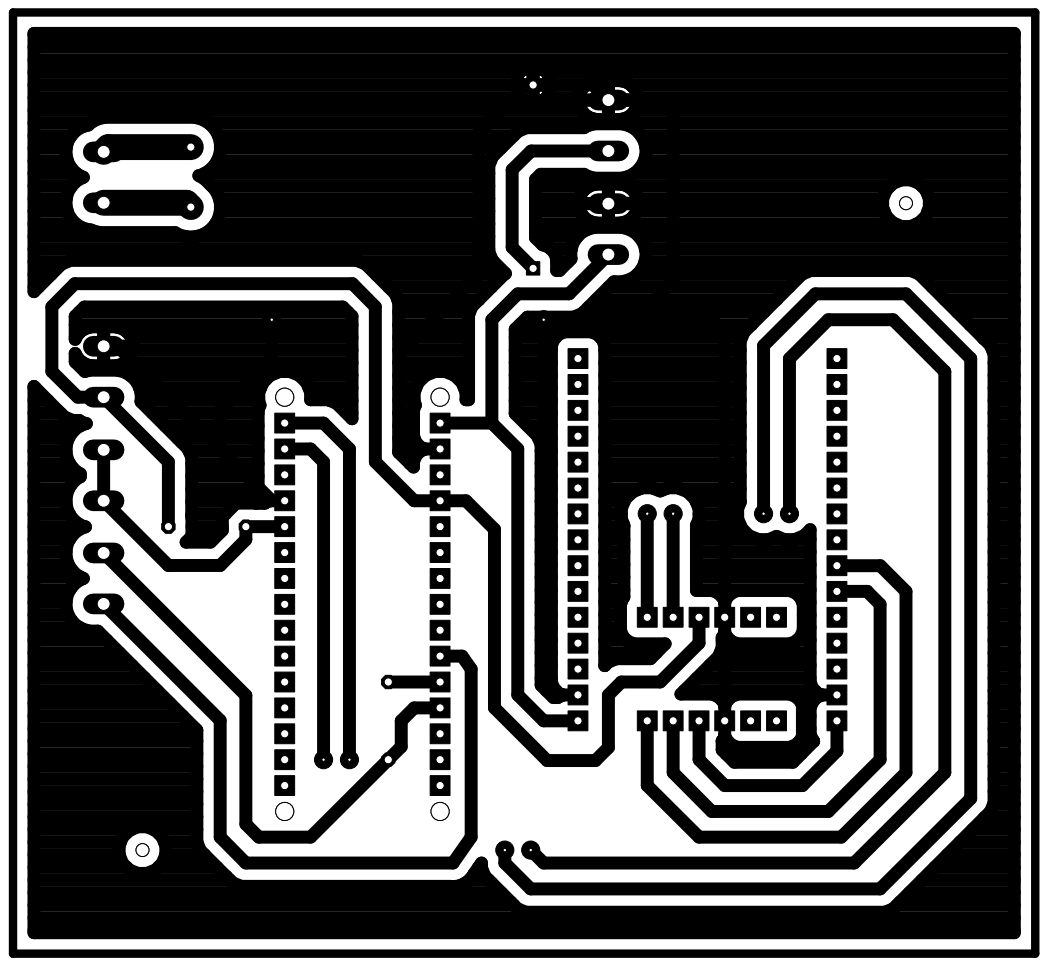
[picture p4: page 1]
