NarinLab/Udawa/Hardware/UDAWA-SensorWater/UDAWA-SensorWater_Silk.pdf

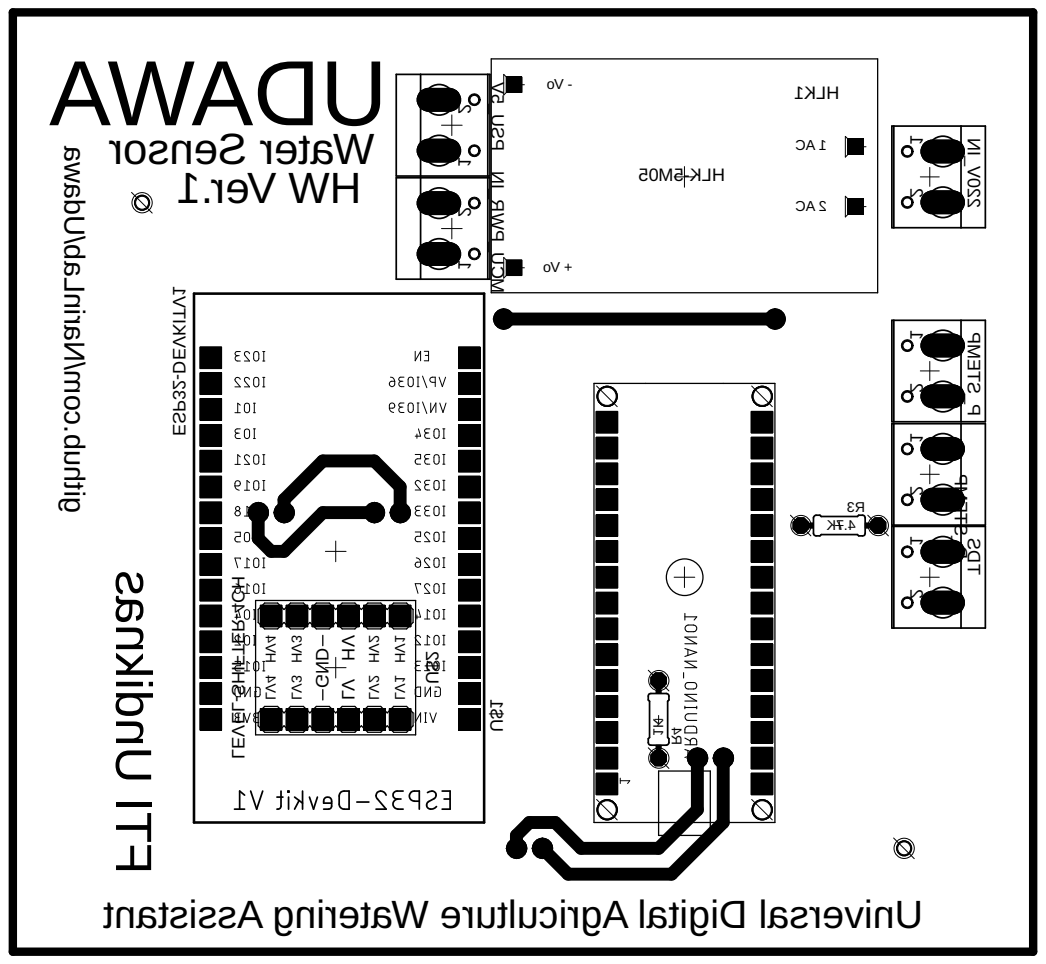
[picture p5: page 1]

github.com/NarinLab/Udawa 1.r eV WH
