NarinLab/Udawa/Hardware/UDAWA-Aktuator4CH/UDAWA-Aktuator4CH.brd

## EAGLE design Hardware/UDAWA-Aktuator4CH/UDAWA-Aktuator4CH.brd (2021-10-11)

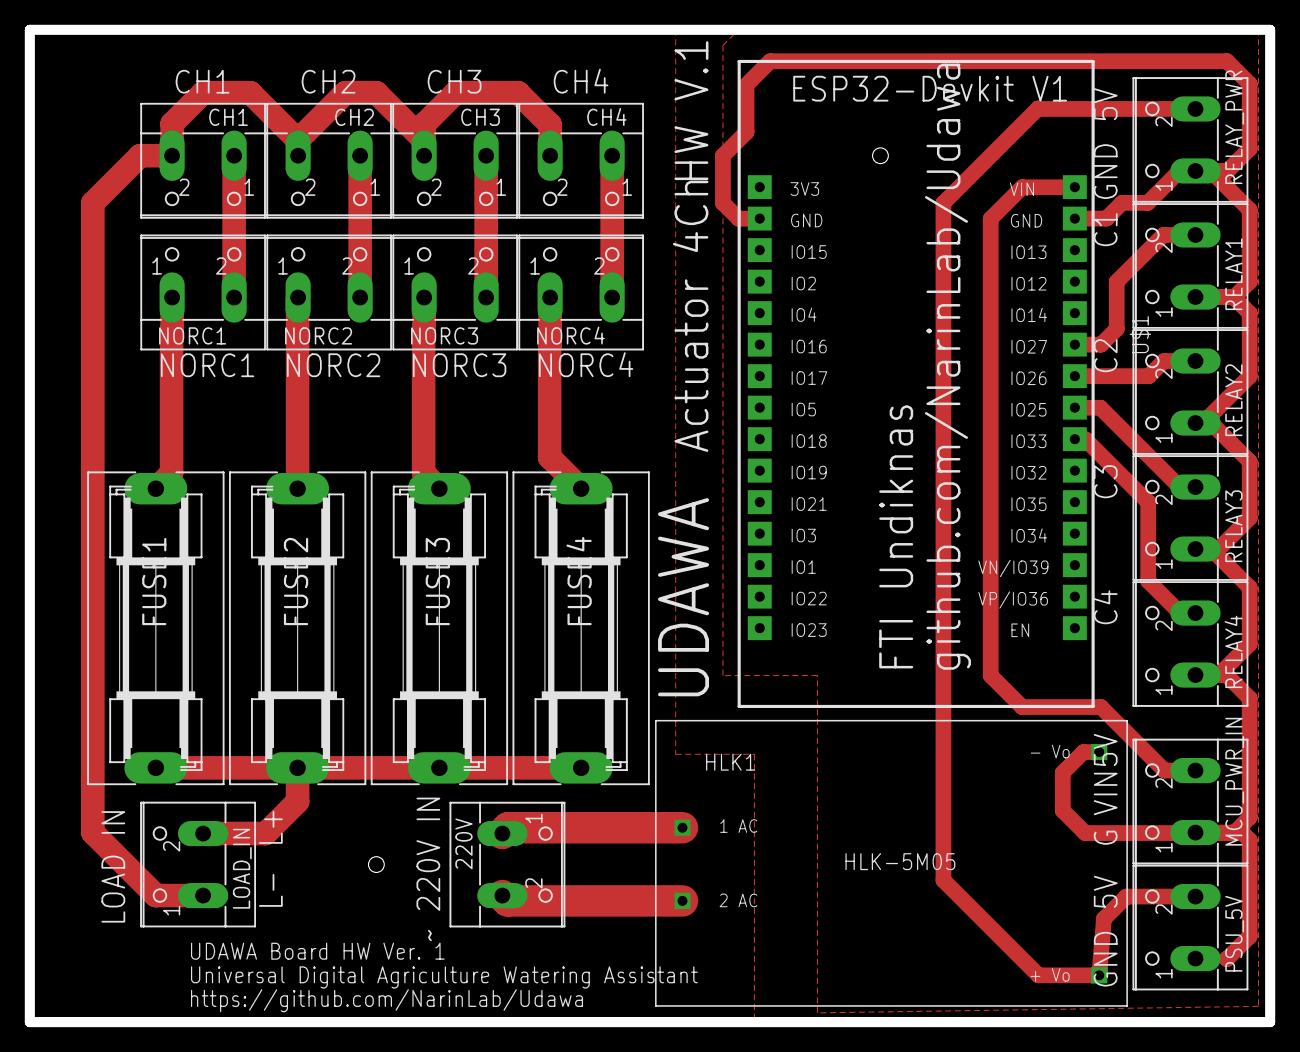
[picture p6: board UDAWA-Aktuator4CH.brd from above]

Board: 2 copper layers, 100.0 x 80.0 mm, 23 parts (0 on the bottom side), 19 nets.

Parts:
220V: W237-102
CH1, CH2, CH3, CH4: W237-102
FUSE1, FUSE2, FUSE3, FUSE4: SH22,5A
HLK1: 5VDC/5W; HLK-5M05
LOAD_IN: W237-102
MCU_PWR_IN: W237-102
NORC1, NORC2, NORC3, NORC4: W237-102
PSU_5V: W237-102
RELAY1, RELAY2, RELAY3, RELAY4: W237-102
RELAY_PWR: W237-102
U$1: ESP32DEVKITV1; ESP32-DEVKITV1

Connections:
5V: HLK1.4, PSU_5V.2, RELAY_PWR.2
AC1: 220V.2, HLK1.1
AC2: 220V.1, HLK1.2
C1: RELAY1.2, U$1.D27
C2: RELAY2.2, U$1.D26
C3: RELAY3.2, U$1.D25
C4: RELAY4.2, U$1.D33
F1: FUSE1.1, NORC1.1
F2: FUSE2.1, NORC2.1
F3: FUSE3.1, NORC3.1
F4: FUSE4.1, NORC4.1
GND: HLK1.3, MCU_PWR_IN.1, PSU_5V.1, RELAY1.1, RELAY2.1, RELAY3.1, RELAY4.1, RELAY_PWR.1, U$1.GND@1, U$1.GND@2
LOAD+: FUSE1.2, FUSE2.2, FUSE3.2, FUSE4.2, LOAD_IN.2
LOAD-: CH1.2, CH2.2, CH3.2, CH4.2, LOAD_IN.1
RC1: CH1.1, NORC1.2
RC2: CH2.1, NORC2.2
RC3: CH3.1, NORC3.2
RC4: CH4.1, NORC4.2
VIN: MCU_PWR_IN.2, U$1.VIN
