NarinLab/Udawa/Hardware/UDAWA-SensorWater/UDAWA-SensorWater.brd

## EAGLE design Hardware/UDAWA-SensorWater/UDAWA-SensorWater.brd (2021-10-11)

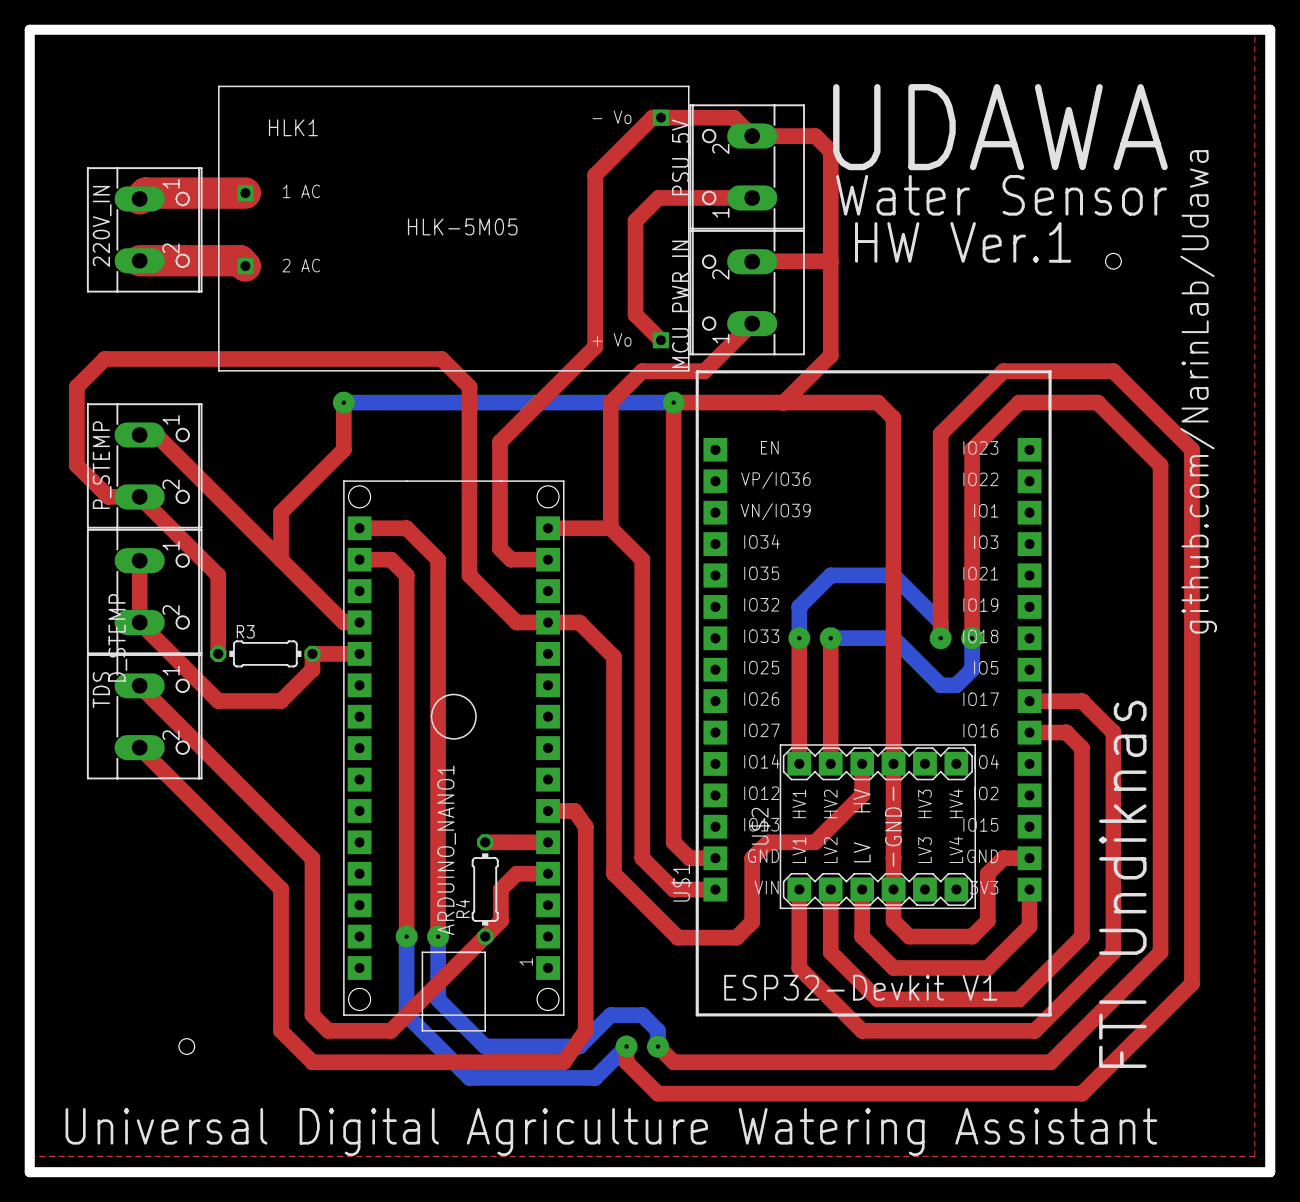
[picture p7: board UDAWA-SensorWater.brd from above]

Board: 2 copper layers, 100.3 x 92.4 mm, 12 parts (0 on the bottom side), 15 nets.

Parts:
220V_IN: W237-102
ARDUINO_NANO1: ARDUINO_NANO
D_STEMP: W237-102
HLK1: 5VDC/5W; HLK-5M05
MCU_PWR_IN: W237-102
PSU_5V: W237-102
P_STEMP: W237-102
R3: 4.7K; 0204/7
R4: 1K; 0204/7
TDS: W237-102
U$1: ESP32DEVKITV1; ESP32-DEVKITV1
U$2: LEVEL-SHIFTER-4CH

Connections:
3V3: U$1.3V3, U$2.J1.3
5V: HLK1.4, PSU_5V.1
5V_NANO: ARDUINO_NANO1.12, P_STEMP.2, R3.1, U$2.J2.3
A0: ARDUINO_NANO1.4, R4.1, TDS.1
A1: ARDUINO_NANO1.5, R4.2
A2: ARDUINO_NANO1.6, TDS.2
AC1: 220V_IN.2, HLK1.1
AC2: 220V_IN.1, HLK1.2
D2: ARDUINO_NANO1.20, D_STEMP.1, D_STEMP.2, R3.2
GND: ARDUINO_NANO1.14, ARDUINO_NANO1.19, HLK1.3, MCU_PWR_IN.2, PSU_5V.2, P_STEMP.1, U$1.GND@1, U$1.GND@2, U$2.J1.4, U$2.J2.4
HV1: ARDUINO_NANO1.17, U$2.J2.1
HV2: ARDUINO_NANO1.16, U$2.J2.2
LV1: U$1.D17, U$2.J1.1
LV2: U$1.D16, U$2.J1.2
VIN: ARDUINO_NANO1.15, MCU_PWR_IN.1, U$1.VIN
