NarinLab/Udawa/Firmware/gadadar/src/main.h

/**
 * UDAWA - Universal Digital Agriculture Watering Assistant
 * Firmware for Actuator 4Ch UDAWA Board (Gadadar)
 * Licensed under aGPLv3
 * Researched and developed by PRITA Research Group & Narin Laboratory
 * prita.undiknas.ac.id | narin.co.id
**/
#ifndef main_h
#define main_h
#include <Arduino.h>
static const char* CA_CERT PROGMEM = R"EOF(
-----BEGIN CERTIFICATE-----
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
-----END CERTIFICATE-----
)EOF";

#define DOCSIZE 1024
#include <libudawa.h>
#include <TimeLib.h>


#define CURRENT_FIRMWARE_TITLE "UDAWA-Gadadar"
#define CURRENT_FIRMWARE_VERSION "0.0.6"

const char* settingsPath = "/settings.json";
struct Settings
{
    uint8_t rlyCtrlMd[4];
    uint8_t dtCyc[4];
    unsigned long dtRng[4];
    uint8_t dtCycFS[4];
    unsigned long dtRngFS[4];
    uint8_t pin[4];
    uint32_t lastUpdated;
    bool ON;
    bool dutyState[4];
    unsigned long dutyCounter[4];
    uint16_t intvRecPwrUsg = 600;
    uint16_t intvGetPwrUsg = 1;
    uint16_t intvDevTel = 1;
    uint32_t rlyActDT[4];
    uint32_t rlyActIT[4];
    unsigned long rlyActDr[4];
    unsigned long rlyActITOn[4];
    unsigned long rlyActITOnTs[4];
    bool publishSwitch[4] = {false, false, false, false};

    uint8_t pinACS = 14;

    float testFreq = 50;
    float windowLength = 40.0;
    float intercept = 0;
    float slope = 0.0752;
    float latestAmpsTRMS;
    float latestACSValue;
    long counterPowerMonitor = 0;
    float accuAmpsTRMS;
    float accuACSValue;
};

callbackResponse processSaveConfig(const callbackData &data);
callbackResponse processSaveSettings(const callbackData &data);
callbackResponse processSharedAttributesUpdate(const callbackData &data);
callbackResponse processSyncClientAttributes(const callbackData &data);
callbackResponse processReboot(const callbackData &data);
callbackResponse processSetSwitch(const callbackData &data);
callbackResponse processGetSwitchCh1(const callbackData &data);
callbackResponse processGetSwitchCh2(const callbackData &data);
callbackResponse processGetSwitchCh3(const callbackData &data);
callbackResponse processGetSwitchCh4(const callbackData &data);
callbackResponse processSaveConfigCoMCU(const callbackData &data);

void loadSettings();
void saveSettings();
void relayControlBydtCyc();
void relayControlByDateTime();
void relayControlByIntrvl();
void syncClientAttributes();
void publishDeviceTelemetry();
void setSwitch(String  ch, String state);
void publishSwitch();
void getPowerUsage();
void recPowerUsage();
uint32_t micro2milli(uint32_t hi, uint32_t lo);

#endif
