NarinLab/Udawa/(commit log)

2021-09-07 Design Pertama board aktuator4CH
    [UDAWA-Aktuator4CH.brd, UDAWA-Aktuator4CH.sch]
2021-09-09 Added Acuator4CH Wiring Driagrams.net
2021-09-09 added sensorwater diagrams.net
2021-09-09 Initialized Actuator4CH-ESP32
2021-09-10 #3 to do list 6&7
    [UDAWA-Aktuator4CH.brd, UDAWA-Aktuator4CH.sch]
2021-09-10 #3 to do list 1 sampai 5
    [UDAWA-Aktuator4CH.sch]
2021-09-10 Inisialisasi firmware projek SensorWater-Nano dan menambahkan library yang diperlukan #9
    Inisialisasi firmware untuk projek SensorWater-Nano dengan PlatformIO
2021-09-13 #3 perbaikan to do list 1sampai5
    [UDAWA-Aktuator4CH.brd, UDAWA-Aktuator4CH.sch]
2021-09-13 penambahan komponen Arduino Nano & Logic Level Converter #6
    baru melakukan wiring & belum melakukan routing pada board
    komponen yang belum ditambahkan : Terminal Block, Sensor TDS, DS18B20
    [UDAWA-SensorWater.brd, UDAWA-SensorWater.sch]
2021-09-13 Inisialisasi projek untuk firmware SensorWater-ESP32 dengan PlatformIO (Pio) #8
    library: NTPClient, ArduinoJson, StreamUtils, LittleFS_esp32, TaskManagerIO
2021-09-14 #3 wiring pada mode board dan pastikan penamaan setiap pin dan konektor dibuat dengan jelas dan rapi sesuai diagram.
    [UDAWA-Aktuator4CH.brd, UDAWA-Aktuator4CH.sch]
2021-09-15 Menambahkan Terminal Block untuk koneksi ke Sensor TDS dan Sensor DS18B20 dan Wiring sesuai diagram di gambar #6
    Menambahkan Terminal Block untuk koneksi ke Sensor TDS dan Sensor DS18B20 dan Wiring sesuai diagram di gambar #6
    [UDAWA-SensorWater.brd, UDAWA-SensorWater.sch]
2021-09-20 Routing PCB #6
    Routing PCB
    [UDAWA-SensorWater.brd, UDAWA-SensorWater.sch]
2021-09-27 #3 list 8
    masih belum lengkap wiringnya karena kabelnya sudah mentok dan bakalan numpuk kalau dipaksakan
    [UDAWA-Aktuator4CH.brd, UDAWA-Aktuator4CH.sch]
2021-10-01 Revert "Merge pull request #16 from NarinLab/sensor-water"
    This reverts commit fa909a87a465dd37d6351bcf5a105db5a344029a, reversing
    changes made to da9ed59faa8e6d8399543247dba95a3195e07114.
    Conflict Error Fix
    [UDAWA-SensorWater.brd, UDAWA-SensorWater.sch]
2021-10-01 First Working Design (Act4CH Board)
    [UDAWA-Aktuator4CH.brd, UDAWA-Aktuator4CH.sch]
2021-10-01 First working version of Water Sensor
    [UDAWA-Aktuator4CH.brd, UDAWA-SensorWater.brd, UDAWA-SensorWater.sch]
2021-10-02 PCB Print Ready
    [UDAWA-Aktuator4CH.brd, UDAWA-Aktuator4CH.sch]
2021-10-06 Revisi terminal catu daya. Solar panel support.
    [UDAWA-Aktuator4CH.brd, UDAWA-Aktuator4CH.sch, UDAWA-SensorWater.brd, UDAWA-SensorWater.sch]
2021-10-07 revisi fuse holder ke SH22,5A (Version 1)
    [UDAWA-Aktuator4CH.brd, UDAWA-Aktuator4CH.sch]
2021-10-07 Update esp32 & nano original lib
2021-10-07 Revert "revisi fuse holder ke SH22,5A (Version 1)"
    This reverts commit d673f62cc688c510ac19bdbae74e3cbf1f8eb5bd.
    ada masalah dengan printscale
    [UDAWA-SensorWater.brd]
2021-10-11 Revisi mirroring. Board tidak mirror. Silkscreen mirror.
    [UDAWA-Aktuator4CH.brd, UDAWA-SensorWater.brd]
2021-10-30 git add .
    [partitions_custom.csv]
2021-11-06 [WIP] Actuator Control
2021-11-06 [WIP] Relay test
2021-11-12 Checkpoint Switching
2021-11-13 Reverse back to 0.0.1 OTA Major Bug
    [main.h]
2021-11-20 added Legacy board actuator support
2021-11-24 0.0.3 Added RPC for SynCConfigCoMCU & reboot
    [main.cpp, main.h]
2021-11-25 Added reboot RPC to Gadadar
    [main.cpp, main.h]
2021-11-26 [Bug Fix] glitches on 100% dutyCycle
    [main.cpp, main.h]
2021-11-26 [Typo Fix] dutyState[i], Gadadar 0.0.3
    [main.cpp]
2022-02-18 [WIP] Relay Control Bug
    [main.cpp, main.h]
2022-03-28 removed hardcoded port and broker. [WIP] Vanilla variant
    [main.cpp, main.h]
2022-04-29 Added various fix in switch
    [main.cpp, main.h]
2022-11-14 added relay control by datetime
2022-12-03 relay control upgrade
